Algias/RobotBasketball/README.md

# RobotBasketball

## ARENA
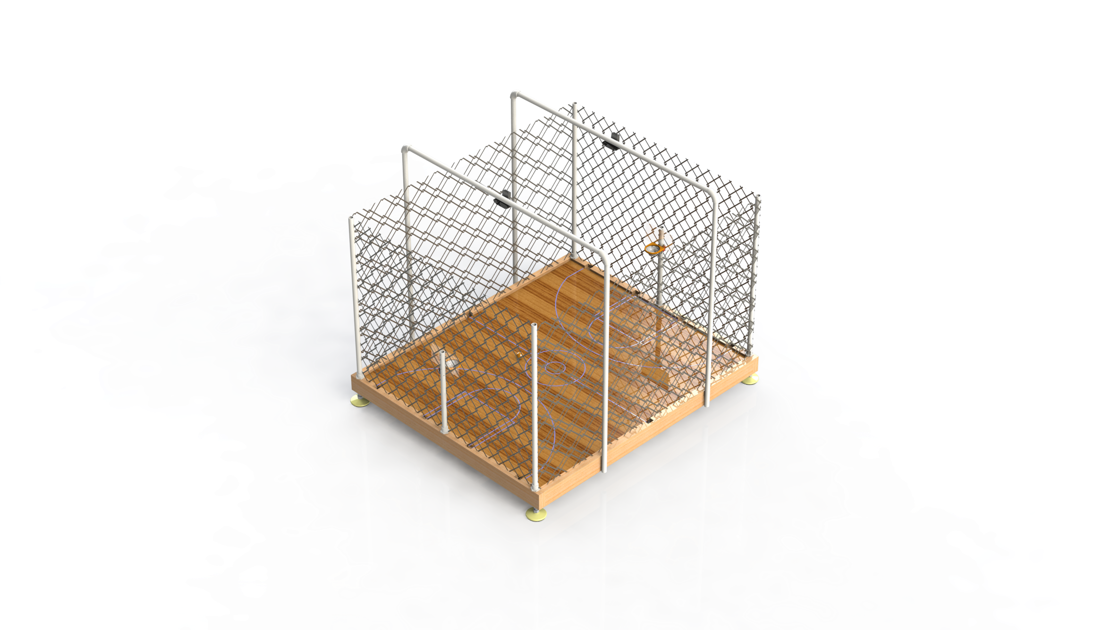
[picture p1: Arena/ArenaRender.png]
Image of Arena

## GAME

## ROBOT
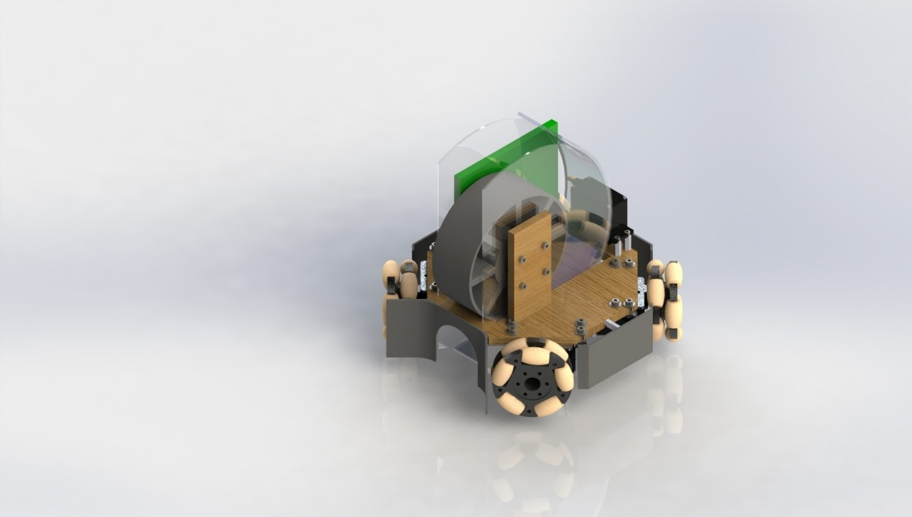
[picture p2: Robot/RobotRender.jpg]
Image of Robot
