Algias/RobotBasketball/Robot/README.md

# Robot
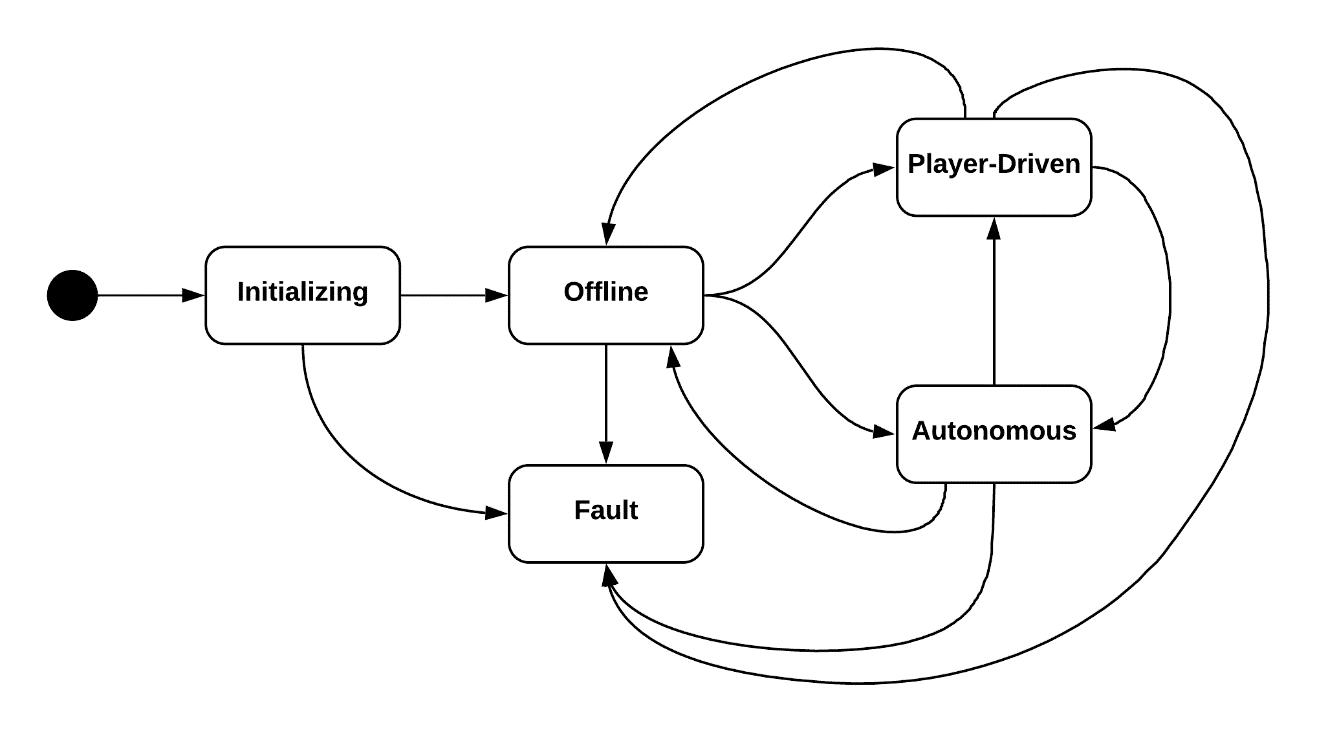
[picture p3: Robot/RobotMasterState.png]
Master States
