Algias/RobotBasketball/Game/Controller.png

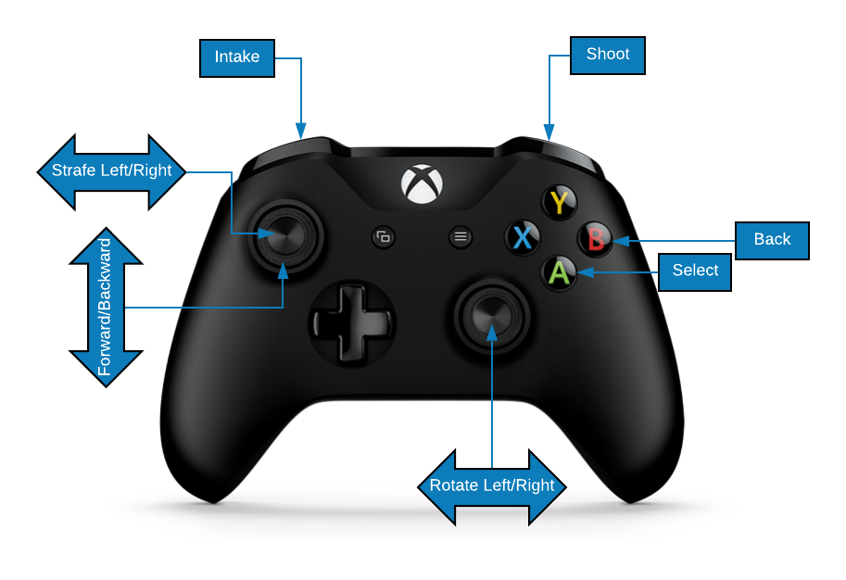
Game/Controller.png
