Algias/RobotBasketball/Game/ControllerNew.png

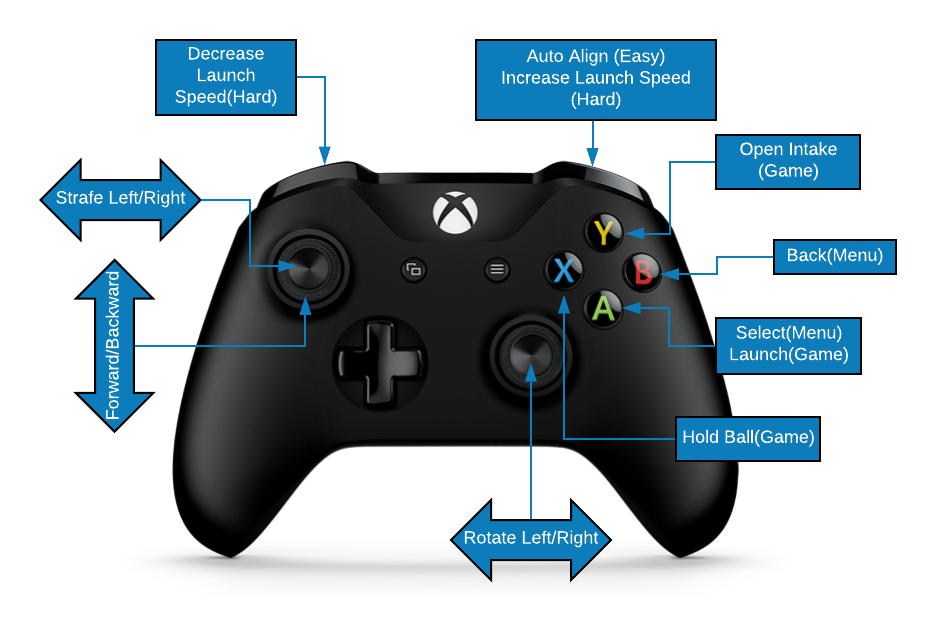
Game/ControllerNew.png
