Algias/RobotBasketball/Game/court.png

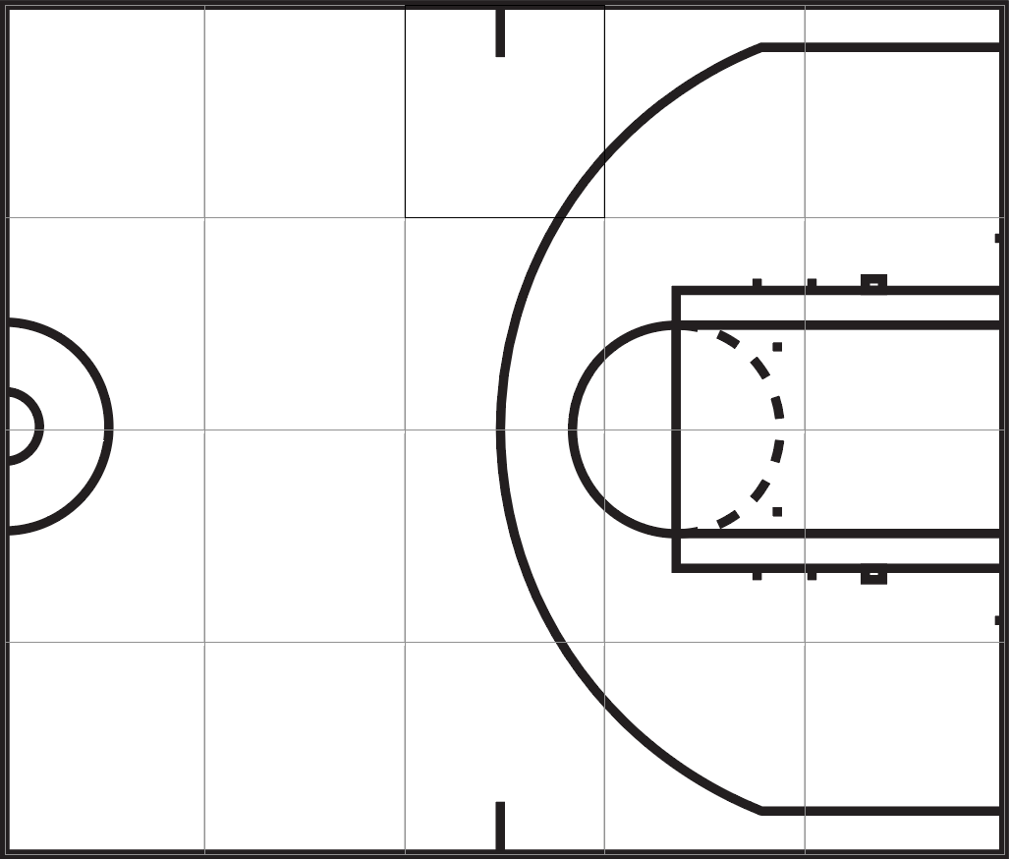
Game/court.png
