Algias/RobotBasketball/Game/CourtImage.png

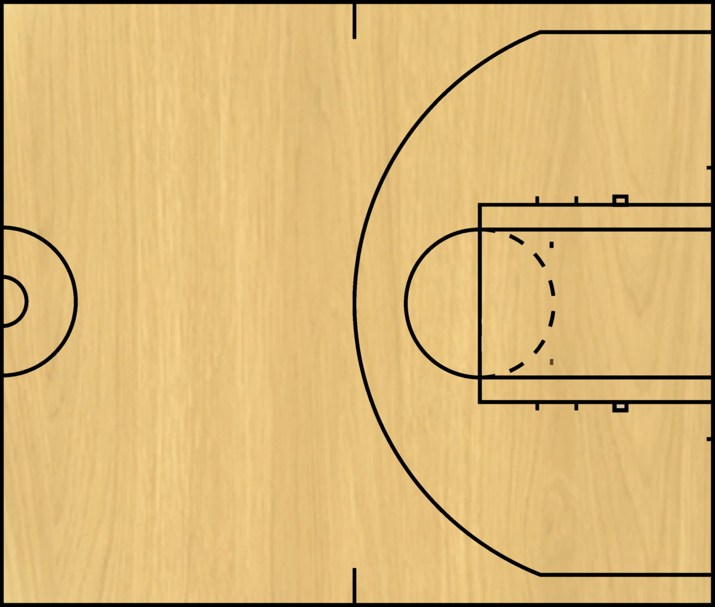
Game/CourtImage.png
