Algias/RobotBasketball/Game/RobotImage.png

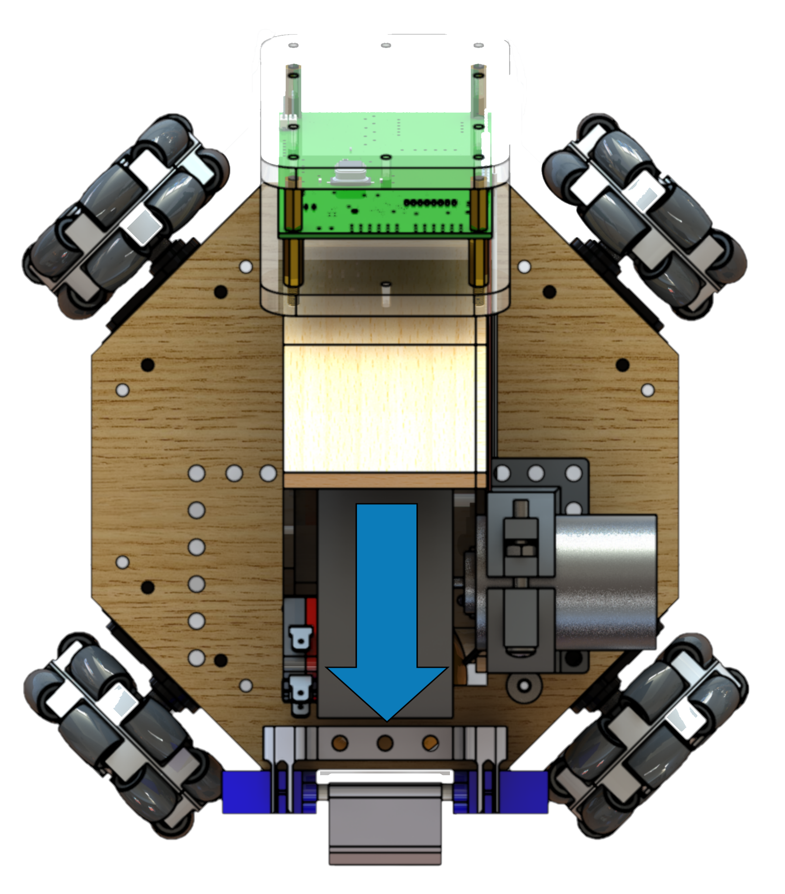
Game/RobotImage.png
