Algias/RobotBasketball/(threads)

Thread 1 (2019-08-27):

Purchase Omni-Wheels [0]

Algias, 2019-08-27:

Algias, 2019-09-04:
[1Z2XW2900328455393](https://wwwapps.ups.com/WebTracking/processInputRequest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)

[Invoice](https://knightsucfedu39751.sharepoint.com/:b:/s/SD2019/ESZpCGnWaOFCuI9vBl3UTkcB__0v1BsZVKSVqe3J961cOQ?e=Qtma7g)

Algias, 2019-09-04:
Delivery delayed due to Hurricane. Moving to Sprint 2

Closed 2019-09-08.

Thread 2 (2019-08-27):

Purchase PCB and Components [0]

Algias, 2019-08-27:

Algias, 2019-10-08:
Files send to manufacturer

Majority of parts purchased
Critical Issue: PWM Generator & Inductor parts not available.

Closed 2019-10-08.

Thread 21 (2019-08-27):

Complete flywheel wheel design [4]

Algias, 2019-08-27:

Algias, 2019-09-10:
Current testing indicates that 3200 RPM on the (3800 RPM) rated motor achieves an average 5ft shot with current parameters. This is short of the required 6 ft shot, and this is at max 12V. Thus, a new motor is purchased rated for 6000RPM in the hopes of having a better variable range that can be tested appropriately. This arrives Tuesday and involves minor changes for testing

Closed 2019-09-16.

Thread 22 (2019-08-27):

Print flywheel [4*]

Algias, 2019-08-27:

Algias, 2019-09-05:
Print took 3.5 Hrs + prep time

Algias, 2019-09-05:
Wheel does not press fit onto shaft. Need to adjust tolerances for mounting hole. Using hot-glue for now!

Closed 2019-09-05.

Thread 27 (2019-08-27):

Test flywheel [8]

Algias, 2019-08-27:
Test the flywheel electronics and hardware (Does not require motor or battery, nor wireless control)

Algias, 2019-09-16:
Preliminary testing resulted in adequate full-court distance launching and relatively high accuracy when holding the robot in place and using the printed hoop mounted at ~12" from the surface.

Closed 2019-09-16.

Thread 46 (2019-09-04):

Assemble remaining Arena hardware

Algias, 2019-09-04:
This includes mesh walls, and adjustable feet.

Corondo1, 2019-09-06:
Arena Leveling feet attached

Corondo1, 2019-09-07:
Arena wall mounts attached

Algias, 2019-09-10:
Cory completed this in Sprint 2. Walls remain to be attached at this time

Closed 2019-09-10.

Thread 47 (2019-09-04):

Design Wheel-Servo Adapter[1]

Algias, 2019-09-04:

Algias, 2019-09-05:
Initial design complete. Involves IQ standoffs, the hub adapter, and a custom printed part.

Closed 2019-09-05.

Thread 48 (2019-09-05):

Design flywheel motor mount[1]

Algias, 2019-09-05:

Algias, 2019-09-05:
The printed motor mount is a simple motor catch that includes pieces to tighten the motor down to the mount and attach the mount to the chassis.

Closed 2019-09-05.

Thread 50 (2019-09-05):

Print flywheel motor mount[4]

Algias, 2019-09-05:
#48 Is the design task

Algias, 2019-09-05:
Printed correctly. Consider swapping one side to a captive nut because the screws I have are too short.

Closed 2019-09-05.

Thread 51 (2019-09-05):

Print 4x wheel hub adapters [3]

Algias, 2019-09-05:
#47 is the design task

Algias, 2019-09-05:
First print complete. Successful mounting. Printing 3 more

Algias, 2019-09-05:
Printing finished

Closed 2019-09-05.

Thread 59 (2019-09-16):

Implement closed loop control for the flywheel [2]

Algias, 2019-09-16:

Algias, 2019-10-08:
Ran into issue with the magnetic encoder. Migrated to new rotary encoder & had mild success. Still need to implement control

Closed 2019-10-12.

Thread 74 (2019-10-16):

Fix wheel for encoder to sit straight

Algias, 2019-10-16:

Closed 2019-10-27.

Thread 78 (2019-10-25):

PCB Rev 2.0 [22]

suvratjain12, 2019-10-25:
-Updated Schematic Design
-Major Updates on PCB Board
-Decreased PCB Size
-Added female connectors for IMU Sensor
-Fixed the parts list for the BOM 2.0
-Checked PCB against the Schematic
-Fixed the copper pours for GND plane
-Generated Gerbers
-Ordered PCB and Stencil

Algias, 2019-11-04:
PCA9635 instead of PCA9685 was used on the board so that does not work. Everything else is fine. Using dev board in meantime

Closed 2019-11-04.

Thread 87 (2019-11-20):

Replace limit switch on hoop with break-beam

Algias, 2019-11-20:

Closed 2019-12-03.

Thread 98 (2019-11-20):

Robot track hits / vibrates on the ground

Algias, 2019-11-20:

Closed 2019-12-03.
