Algias/RobotBasketball/Arena/Peripheral/BreakBeamCode/BreakBeamCode.ino

/* 
  IR Breakbeam sensor demo!
*/

#define LEDPIN 13
  // Pin 13: Arduino has an LED connected on pin 13
  // Pin 11: Teensy 2.0 has the LED on pin 11
  // Pin  6: Teensy++ 2.0 has the LED on pin 6
  // Pin 13: Teensy 3.0 has the LED on pin 13

#define SENSORPIN 8

// variables will change:
int sensorState = 0, lastState=0;         // variable for reading the pushbutton status

long lastScoreTime = 0;


void setup() {
  // initialize the LED pin as an output:
  pinMode(LEDPIN, OUTPUT);      
  // initialize the sensor pin as an input:
  pinMode(SENSORPIN, INPUT);     
  digitalWrite(SENSORPIN, HIGH); // turn on the pullup
  
  Serial.begin(9600);
}

void loop(){
  // read the state of the pushbutton value:
  sensorState = digitalRead(SENSORPIN);

  if (!sensorState && lastState && (millis() - lastScoreTime) > 500) {
    Serial.println("1");
    lastScoreTime = millis();
  }
  lastState = sensorState;
}
