Algias/RobotBasketball/(commit log)

2019-08-25 Arduino Project initial creation & VsCode files
2019-12-03 End of Semester Merge (#101)
    * Actuator code continued + library files
    * Make interfaces and add additional functionality
    * Reformatting
    * Drive application code and other adjustments
    * Adjust actuators to integer logic
    * first PID Implementations
    * General additions
    * Integer fix
    * Drive-Test specific code
    * Drive Test input
    * Functional Drive test additions/changes
    * PID Additions
    * PID Loop additions
    * remove libraries from repo
    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
    [Actuator.cpp, Actuator.h, BreakBeamCode.ino, Communication.cpp, Communication.h, Constants.h, Drive.cpp, Drive.h]
